AFMicr0/AnyScreenTouchScreen/README.md

# AnyScreenTouchScreen
ECE 445 Final Project

We have another repository for this project here:
https://github.com/Sakhiyuvio/Any-Screen-to-Touch-Screen
