AFMicr0/AnyScreenTouchScreen/Any-Screen-Touch-Screen_AnchorMod/Any-Screen-Touch-Screen_AnchorMod.kicad_pcb

## KiCad design Any-Screen-Touch-Screen_AnchorMod/Any-Screen-Touch-Screen_AnchorMod.kicad_pcb (2024-10-13)

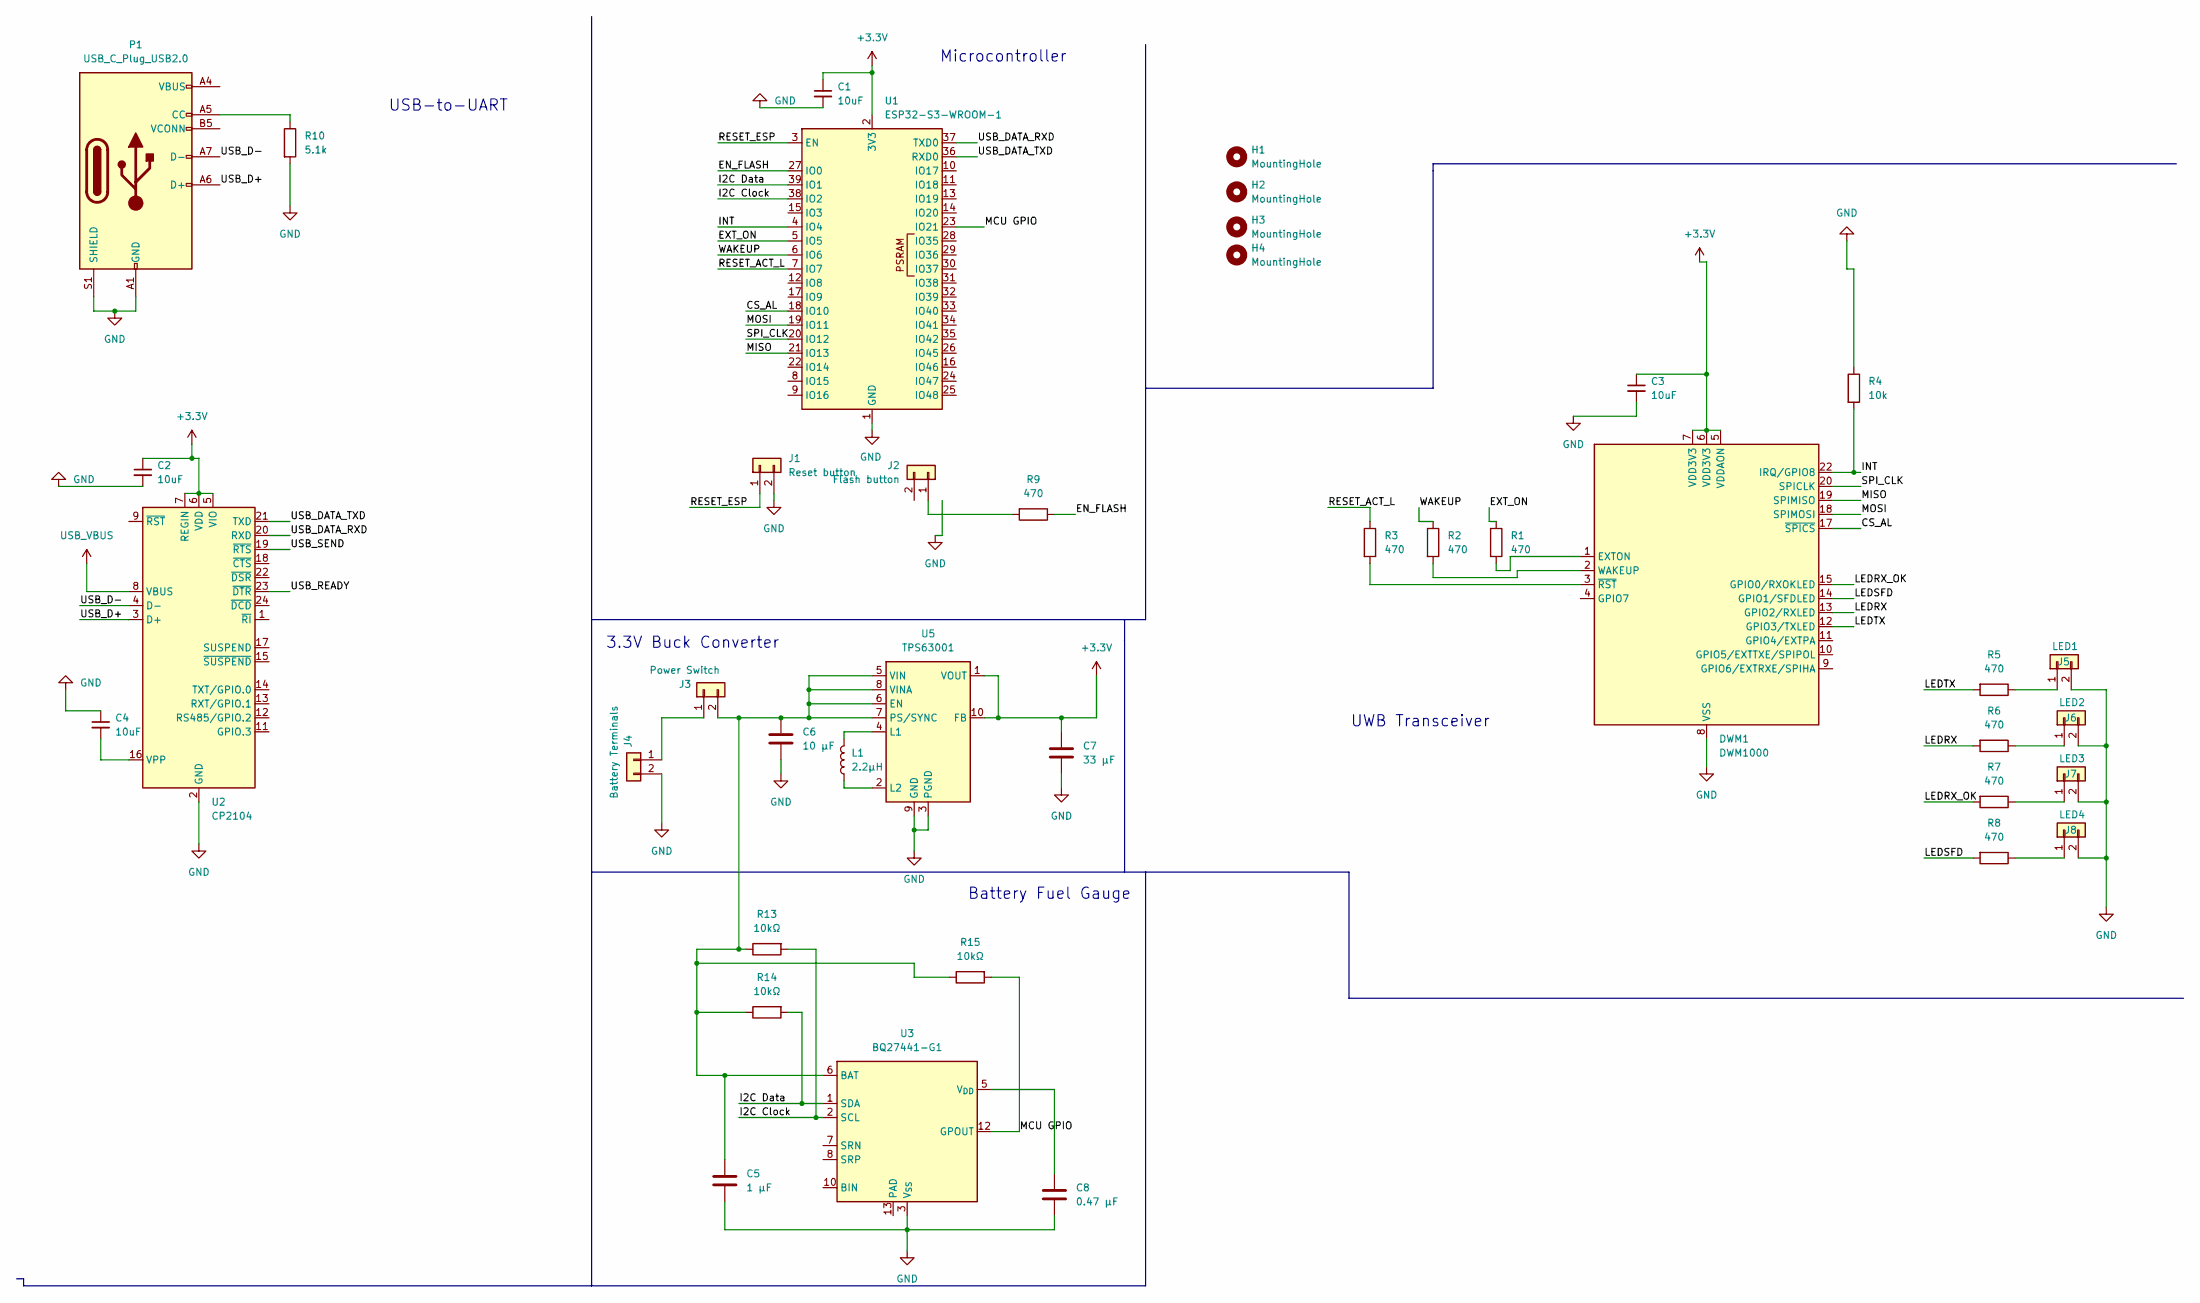
[picture p20: schematic Any-Screen-Touch-Screen_AnchorMod.kicad_sch]

Parts:
C1, C2, C3, C4: 10uF; C_0805_2012Metric_Pad1.18x1.45mm_HandSolder
C5: 1 μF; C_0805_2012Metric_Pad1.18x1.45mm_HandSolder
C6: 10 μF; C_0805_2012Metric_Pad1.18x1.45mm_HandSolder
C7: 33 μF; C_0805_2012Metric_Pad1.18x1.45mm_HandSolder
C8: 0.47 μF; C_0805_2012Metric_Pad1.18x1.45mm_HandSolder
DWM1: DWM1000
H1, H2, H3, H4: MountingHole; MountingHole_3.2mm_M3
J1: Reset button; Molex_KK-254_AE-6410-02A_1x02_P2.54mm_Vertical
J2: Flash button; Molex_KK-254_AE-6410-02A_1x02_P2.54mm_Vertical
J3: Power Switch; Molex_KK-254_AE-6410-02A_1x02_P2.54mm_Vertical
J4: Battery Terminals; Molex_KK-254_AE-6410-02A_1x02_P2.54mm_Vertical
J5: LED1; Molex_KK-254_AE-6410-02A_1x02_P2.54mm_Vertical
J6: LED2; Molex_KK-254_AE-6410-02A_1x02_P2.54mm_Vertical
J7: LED3; Molex_KK-254_AE-6410-02A_1x02_P2.54mm_Vertical
J8: LED4; Molex_KK-254_AE-6410-02A_1x02_P2.54mm_Vertical
L1: 2.2μH; IND_MSS5131_COC
P1: USB_C_Plug_USB2.0; USB_C_Plug_Molex_105444
R1, R2, R3, R5, R6, R7, R8, R9: 470; R_0805_2012Metric_Pad1.20x1.40mm_HandSolder
R4: 10k; R_0805_2012Metric_Pad1.20x1.40mm_HandSolder
R10: 5.1k; R_0805_2012Metric_Pad1.20x1.40mm_HandSolder
R13, R14, R15: 10kΩ; R_0805_2012Metric_Pad1.20x1.40mm_HandSolder
U1: ESP32-S3-WROOM-1
U2: CP2104; QFN-24-1EP_4x4mm_P0.5mm_EP2.7x2.7mm_ThermalVias
U3: BQ27441-G1; Texas_S-PDSO-N12
U5: TPS63001; Texas_DRC0010J_ThermalVias

Connections:
+3.3V: C1.1, C2.1, C3.1, C7.1, DWM1.5 (VDDAON), DWM1.6 (VDD3V3), DWM1.7 (VDD3V3), U1.2 (3V3), U2.5 (VIO), U2.6 (VDD), U2.7 (REGIN), U5.1 (VOUT), U5.10 (FB)
/CS_AL: DWM1.17 (~SPICS), U1.18 (IO10)
/EN_FLASH: R9.1, U1.27 (IO0)
/EXT_ON: R1.1, U1.5 (IO5)
/I2C Clock: R13.2, U1.38 (IO2), U3.2 (SCL)
/I2C Data: R14.2, U1.39 (IO1), U3.1 (SDA)
/INT: DWM1.22 (IRQ/GPIO8), R4.2, U1.4 (IO4)
/LEDRX: DWM1.13 (GPIO2/RXLED), R6.2
/LEDRX_OK: DWM1.15 (GPIO0/RXOKLED), R7.2
/LEDSFD: DWM1.14 (GPIO1/SFDLED), R8.2
/LEDTX: DWM1.12 (GPIO3/TXLED), R5.2
/MCU GPIO: R15.2, U1.23 (IO21), U3.12 (GPOUT)
/MISO: DWM1.19 (SPIMISO), U1.21 (IO13)
/MOSI: DWM1.18 (SPIMOSI), U1.19 (IO11)
/RESET_ACT_L: R3.1, U1.7 (IO7)
/RESET_ESP: J1.1, U1.3 (EN)
/SPI_CLK: DWM1.20 (SPICLK), U1.20 (IO12)
/USB_D+: P1.A6 (D+), U2.3 (D+)
/USB_D-: P1.A7 (D-), U2.4 (D-)
/USB_DATA_RXD: U1.37 (TXD0), U2.20 (RXD)
/USB_DATA_TXD: U1.36 (RXD0), U2.21 (TXD)
/USB_READY: U2.23 (~DTR)
/USB_SEND: U2.19 (~RTS)
/WAKEUP: R2.1, U1.6 (IO6)
GND: C1.2, C2.2, C3.2, C4.1, C5.2, C6.1, C7.2, C8.2, DWM1.8 (VSS), DWM1.16 (VSS), DWM1.21 (VSS), DWM1.23 (VSS), DWM1.24 (VSS), J1.2, J4.2, J5.2, J6.2, J7.2, J8.2, P1.A1 (GND), P1.A12 (GND), P1.B1 (GND), P1.B12 (GND), P1.S1 (SHIELD), R4.1, R10.2, U1.1 (GND), U1.40 (GND), U1.41 (GND), U2.2 (GND), U2.25 (GND), U3.3 (V_{SS}), U5.3 (PGND), U5.9 (GND), U5.11 (PGND)
unnamed: DWM1.1 (EXTON), R1.2
unnamed: DWM1.2 (WAKEUP), R2.2
unnamed: DWM1.3 (~RST), R3.2
unnamed: J2.1, R9.2
unnamed: J3.1, J4.1
unnamed: C5.1, C6.2, J3.2, R13.1, R14.1, R15.1, U3.6 (BAT), U5.5 (VIN), U5.6 (EN), U5.7 (PS/SYNC), U5.8 (VINA)
unnamed: J5.1, R5.1
unnamed: J6.1, R6.1
unnamed: J7.1, R7.1
unnamed: J8.1, R8.1
unnamed: P1.A5 (CC), R10.1
unnamed: P1.A4 (VBUS), P1.A9 (VBUS), P1.B4 (VBUS), P1.B9 (VBUS)
unnamed: C4.2, U2.16 (VPP)
unnamed: C8.1, U3.5 (V_{DD})
unnamed: L1.2, U5.4 (L1)
unnamed: L1.1, U5.2 (L2)
USB_VBUS: U2.8 (VBUS)

Notes on the sheet:
USB-to-UART
Microcontroller
3.3V Buck Converter
Battery Fuel Gauge
UWB Transceiver

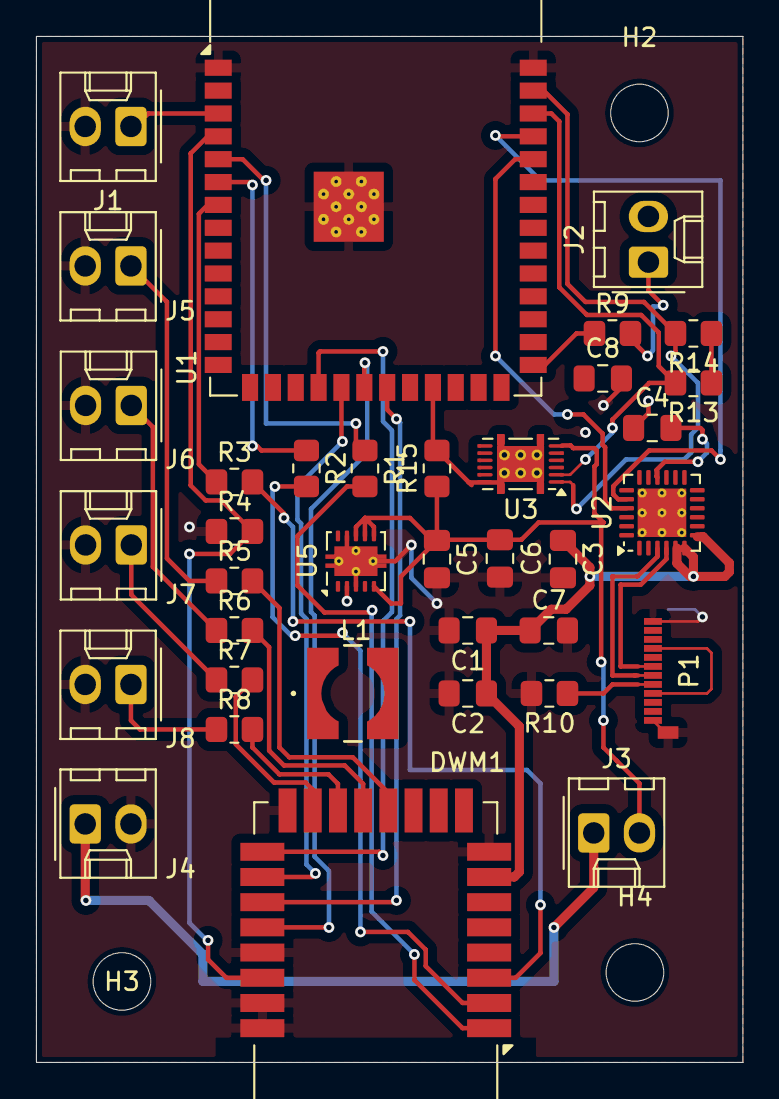
[picture p21: board Any-Screen-Touch-Screen_AnchorMod.kicad_pcb from above]

Board: 2 copper layers, 39.2 x 57.0 mm, 40 parts (0 on the bottom side), 39 nets.
