AFMicr0/AnyScreenTouchScreen/PCB design/Pen and Anchor Schematics/Any-Screen-Touch-Screen_AnchorMod.kicad_sch

## KiCad design PCB design/Pen and Anchor Schematics/Any-Screen-Touch-Screen_AnchorMod.kicad_sch (2024-10-01)

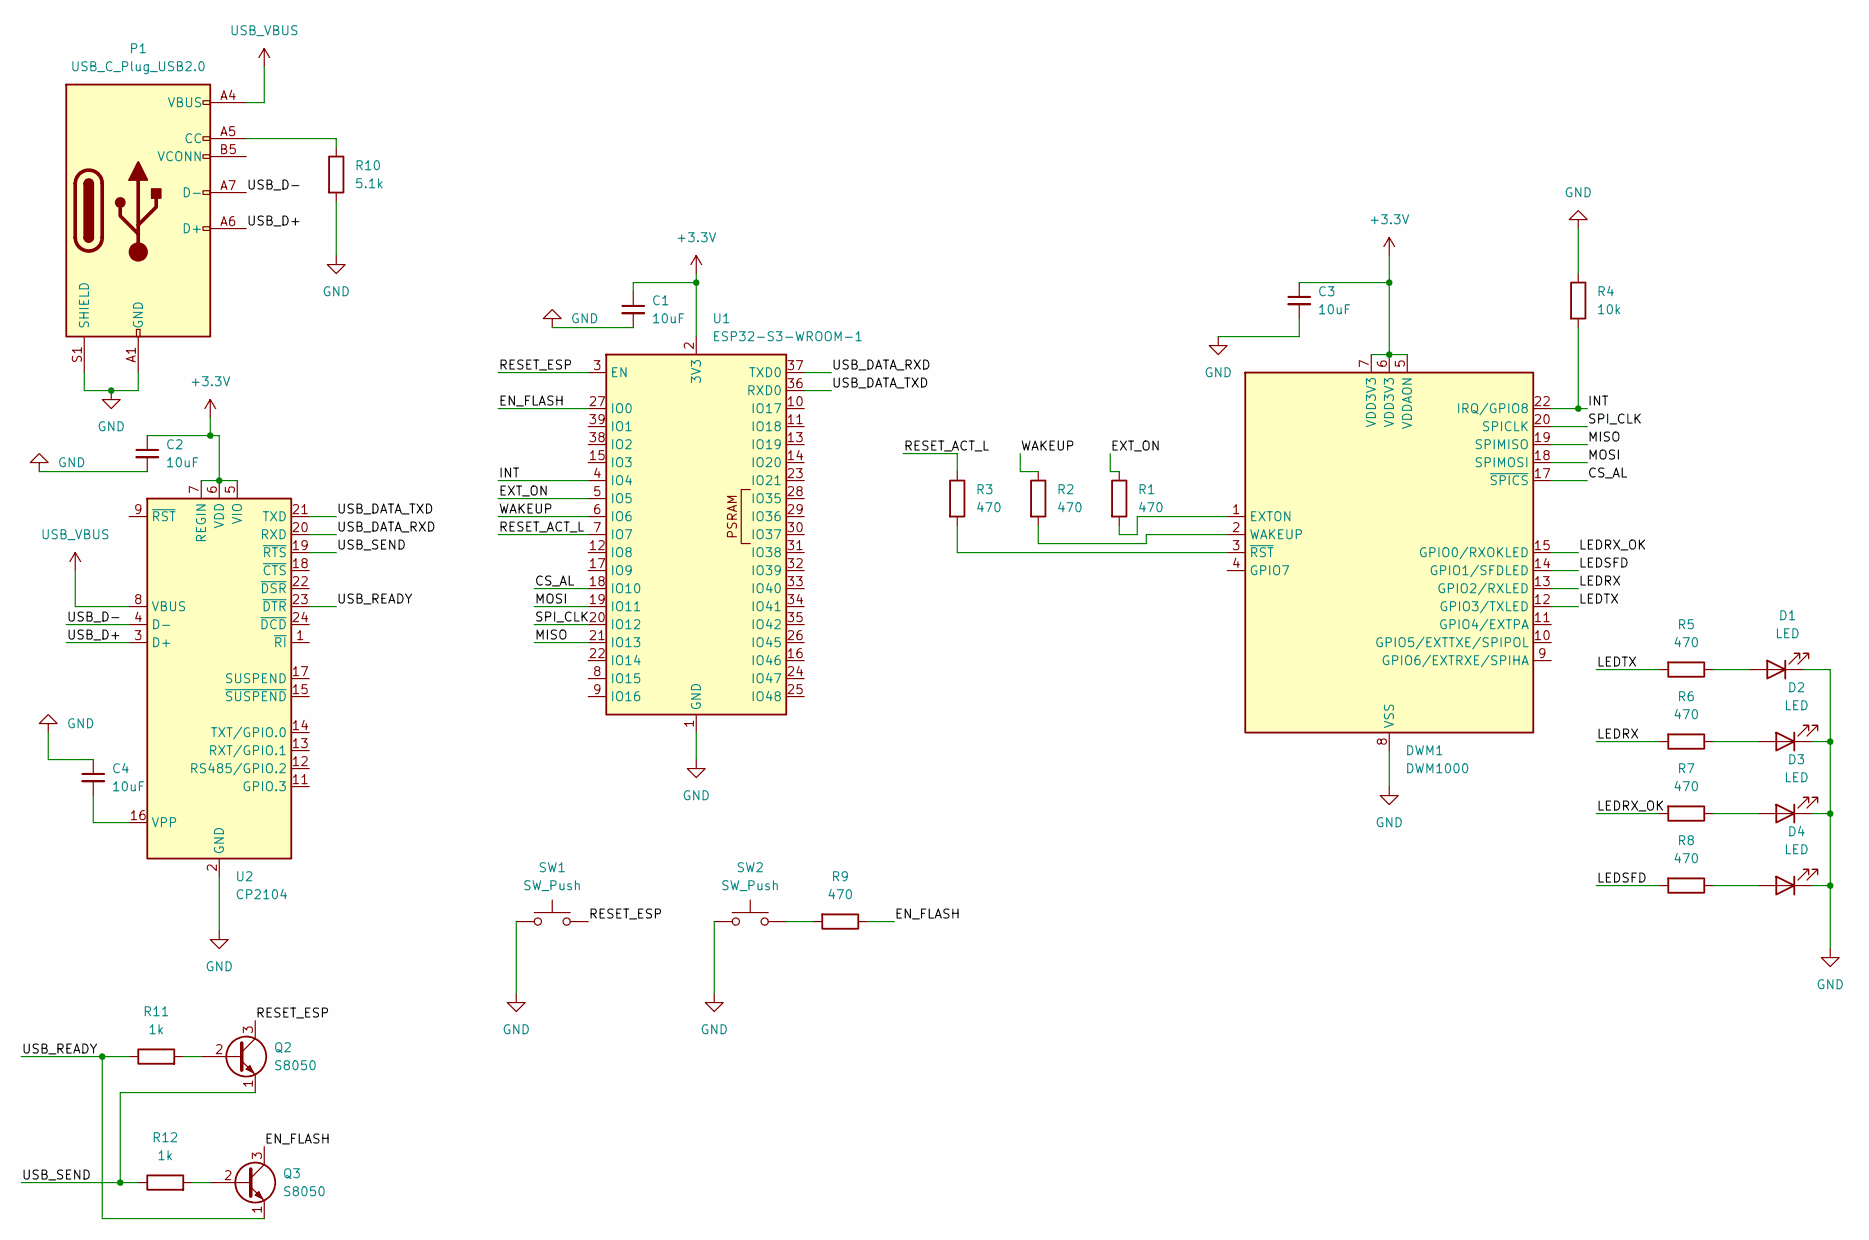
[picture p22: schematic Any-Screen-Touch-Screen_AnchorMod.kicad_sch]

Parts:
C1, C2, C3, C4: 10uF
D1, D2, D3, D4: LED
DWM1: DWM1000
P1: USB_C_Plug_USB2.0
Q2, Q3: S8050; TO-92_Inline
R1, R2, R3, R5, R6, R7, R8, R9: 470
R4: 10k
R10: 5.1k
R11, R12: 1k
SW1, SW2: SW_Push
U1: ESP32-S3-WROOM-1
U2: CP2104; QFN-24-1EP_4x4mm_P0.5mm_EP2.6x2.6mm

Connections:
+3.3V: C1.1, C2.1, C3.1, DWM1.5 (VDDAON), DWM1.6 (VDD3V3), DWM1.7 (VDD3V3), U1.2 (3V3), U2.5 (VIO), U2.6 (VDD), U2.7 (REGIN)
CS_AL: DWM1.17 (~SPICS), U1.18 (IO10)
EN_FLASH: Q3.3 (C), R9.1, U1.27 (IO0)
EXT_ON: R1.1, U1.5 (IO5)
GND: C1.2, C2.2, C3.2, C4.1, D1.1 (K), D2.1 (K), D3.1 (K), D4.1 (K), DWM1.8 (VSS), DWM1.16 (VSS), DWM1.21 (VSS), DWM1.23 (VSS), DWM1.24 (VSS), P1.A1 (GND), P1.A12 (GND), P1.B1 (GND), P1.B12 (GND), P1.S1 (SHIELD), R4.1, R10.2, SW1.1, SW2.1, U1.1 (GND), U1.40 (GND), U1.41 (GND), U2.2 (GND), U2.25 (GND)
INT: DWM1.22 (IRQ/GPIO8), R4.2, U1.4 (IO4)
LEDRX: DWM1.13 (GPIO2/RXLED), R6.2
LEDRX_OK: DWM1.15 (GPIO0/RXOKLED), R7.2
LEDSFD: DWM1.14 (GPIO1/SFDLED), R8.2
LEDTX: DWM1.12 (GPIO3/TXLED), R5.2
MISO: DWM1.19 (SPIMISO), U1.21 (IO13)
MOSI: DWM1.18 (SPIMOSI), U1.19 (IO11)
unnamed: C4.2, U2.16 (VPP)
unnamed: D1.2 (A), R5.1
unnamed: D2.2 (A), R6.1
unnamed: D3.2 (A), R7.1
unnamed: D4.2 (A), R8.1
unnamed: DWM1.1 (EXTON), R1.2
unnamed: DWM1.2 (WAKEUP), R2.2
unnamed: DWM1.3 (~RST), R3.2
unnamed: P1.A5 (CC), R10.1
unnamed: Q2.2 (B), R11.2
unnamed: Q3.2 (B), R12.2
unnamed: R9.2, SW2.2
RESET_ACT_L: R3.1, U1.7 (IO7)
RESET_ESP: Q2.3 (C), SW1.2, U1.3 (EN)
SPI_CLK: DWM1.20 (SPICLK), U1.20 (IO12)
USB_D+: P1.A6 (D+), U2.3 (D+)
USB_D-: P1.A7 (D-), U2.4 (D-)
USB_DATA_RXD: U1.37 (TXD0), U2.20 (RXD)
USB_DATA_TXD: U1.36 (RXD0), U2.21 (TXD)
USB_READY: Q3.1 (E), R11.1, U2.23 (~DTR)
USB_SEND: Q2.1 (E), R12.1, U2.19 (~RTS)
USB_VBUS: P1.A4 (VBUS), P1.A9 (VBUS), P1.B4 (VBUS), P1.B9 (VBUS), U2.8 (VBUS)
WAKEUP: R2.1, U1.6 (IO6)
