AFMicr0/AnyScreenTouchScreen/PCB design/Pen and Anchor Schematics/Any-Screen-Touch-Screen_Pen.kicad_sch

## KiCad design PCB design/Pen and Anchor Schematics/Any-Screen-Touch-Screen_Pen.kicad_sch (2024-10-01)

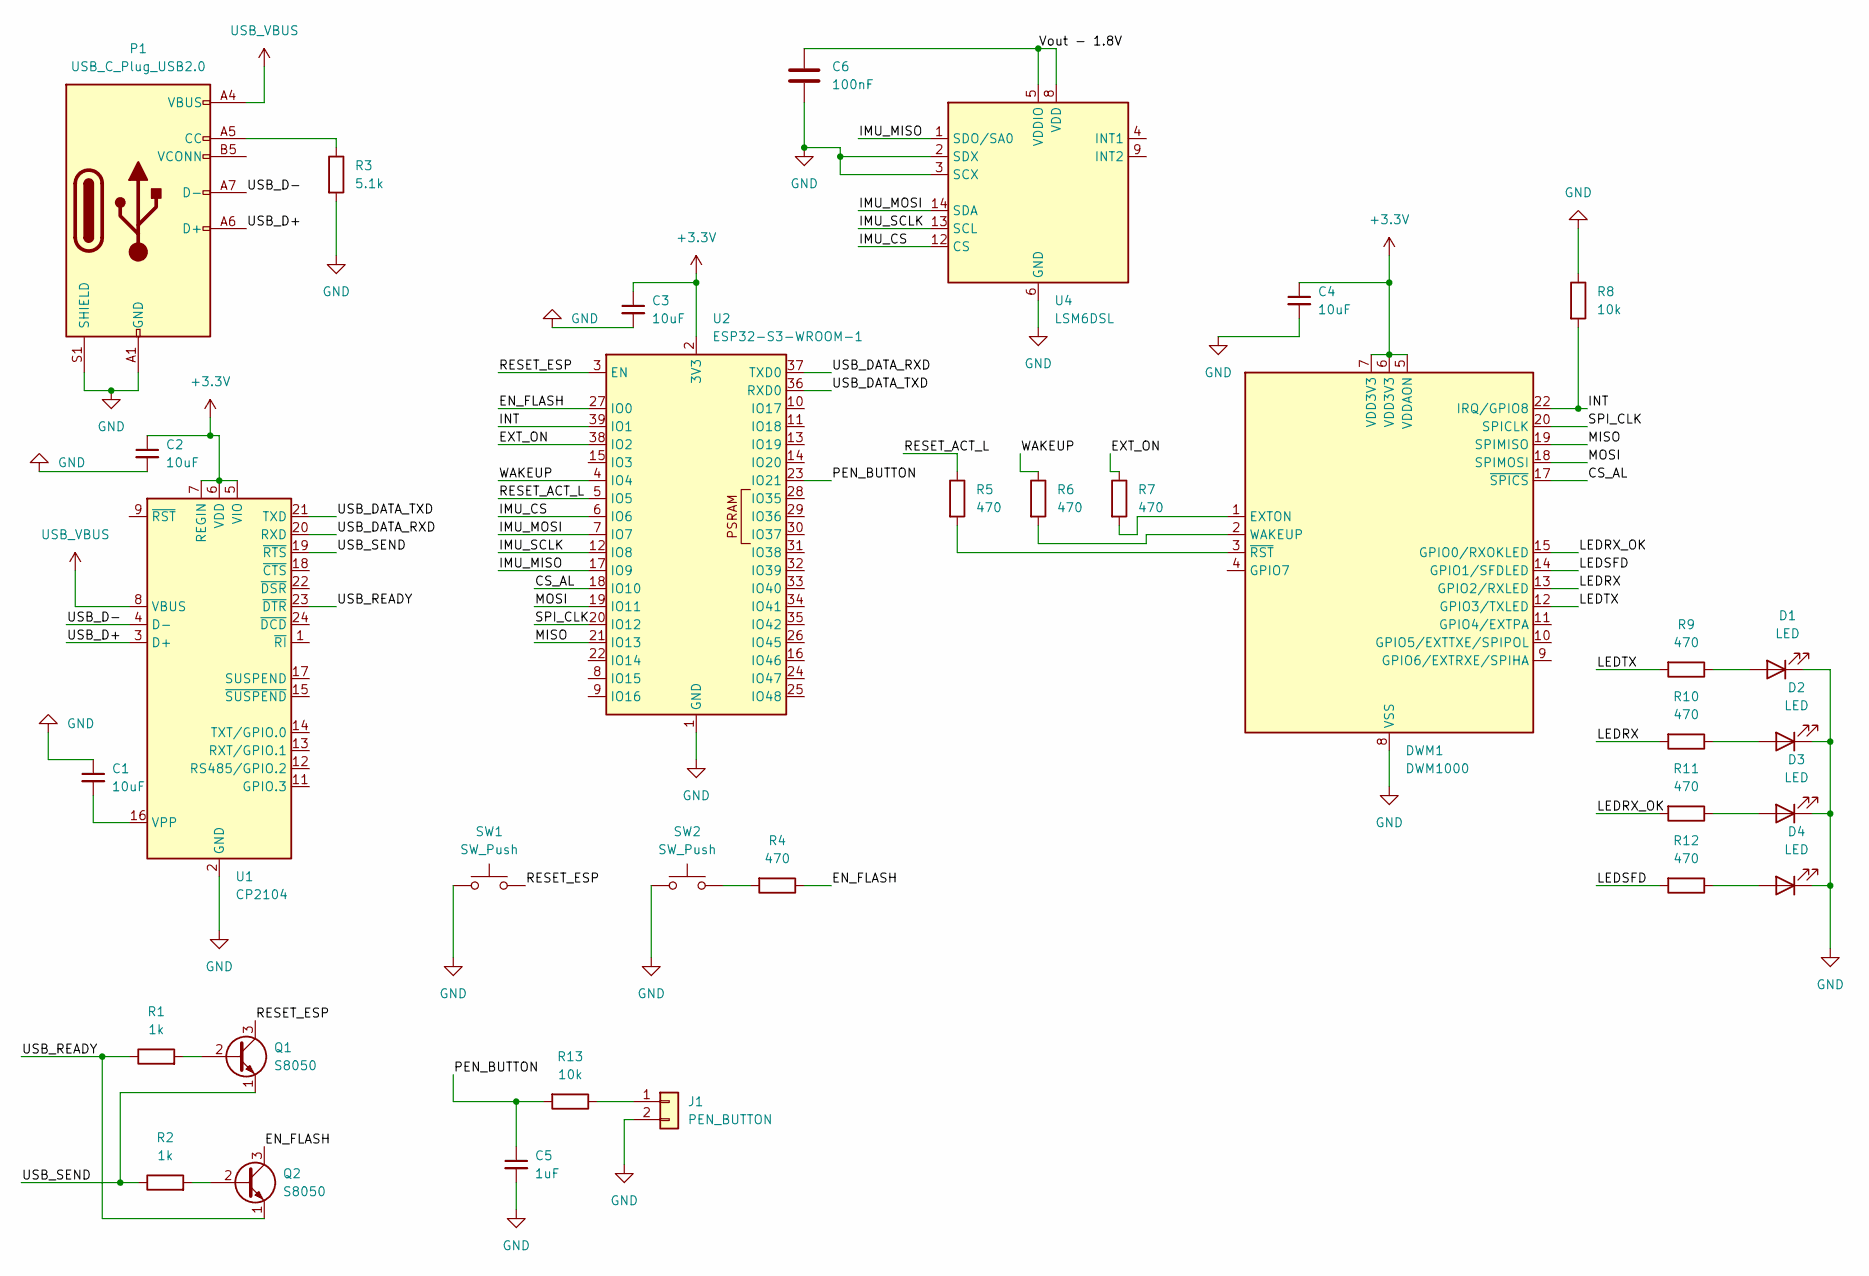
[picture p23: schematic Any-Screen-Touch-Screen_Pen.kicad_sch]

Parts:
C1, C2, C3, C4: 10uF
C5: 1uF
C6: 100nF
D1, D2, D3, D4: LED
DWM1: DWM1000
J1: PEN_BUTTON
P1: USB_C_Plug_USB2.0
Q1, Q2: S8050; TO-92_Inline
R1, R2: 1k
R3: 5.1k
R4, R5, R6, R7, R9, R10, R11, R12: 470
R8, R13: 10k
SW1, SW2: SW_Push
U1: CP2104; QFN-24-1EP_4x4mm_P0.5mm_EP2.6x2.6mm
U2: ESP32-S3-WROOM-1
U4: LSM6DSL; LGA-14_3x2.5mm_P0.5mm_LayoutBorder3x4y

Connections:
+3.3V: C2.1, C3.1, C4.1, DWM1.5 (VDDAON), DWM1.6 (VDD3V3), DWM1.7 (VDD3V3), U1.5 (VIO), U1.6 (VDD), U1.7 (REGIN), U2.2 (3V3)
CS_AL: DWM1.17 (~SPICS), U2.18 (IO10)
EN_FLASH: Q2.3 (C), R4.1, U2.27 (IO0)
EXT_ON: R7.1, U2.38 (IO2)
GND: C1.1, C2.2, C3.2, C4.2, C5.2, C6.2, D1.1 (K), D2.1 (K), D3.1 (K), D4.1 (K), DWM1.8 (VSS), DWM1.16 (VSS), DWM1.21 (VSS), DWM1.23 (VSS), DWM1.24 (VSS), J1.2, P1.A1 (GND), P1.A12 (GND), P1.B1 (GND), P1.B12 (GND), P1.S1 (SHIELD), R3.2, R8.1, SW1.1, SW2.1, U1.2 (GND), U1.25 (GND), U2.1 (GND), U2.40 (GND), U2.41 (GND), U4.2 (SDX), U4.3 (SCX), U4.6 (GND), U4.7 (GND)
IMU_CS: U2.6 (IO6), U4.12 (CS)
IMU_MISO: U2.17 (IO9), U4.1 (SDO/SA0)
IMU_MOSI: U2.7 (IO7), U4.14 (SDA)
IMU_SCLK: U2.12 (IO8), U4.13 (SCL)
INT: DWM1.22 (IRQ/GPIO8), R8.2, U2.39 (IO1)
LEDRX: DWM1.13 (GPIO2/RXLED), R10.2
LEDRX_OK: DWM1.15 (GPIO0/RXOKLED), R11.2
LEDSFD: DWM1.14 (GPIO1/SFDLED), R12.2
LEDTX: DWM1.12 (GPIO3/TXLED), R9.2
MISO: DWM1.19 (SPIMISO), U2.21 (IO13)
MOSI: DWM1.18 (SPIMOSI), U2.19 (IO11)
unnamed: C1.2, U1.16 (VPP)
unnamed: D1.2 (A), R9.1
unnamed: D2.2 (A), R10.1
unnamed: D3.2 (A), R11.1
unnamed: D4.2 (A), R12.1
unnamed: DWM1.1 (EXTON), R7.2
unnamed: DWM1.2 (WAKEUP), R6.2
unnamed: DWM1.3 (~RST), R5.2
unnamed: J1.1, R13.1
unnamed: P1.A5 (CC), R3.1
unnamed: Q1.2 (B), R1.2
unnamed: Q2.2 (B), R2.2
unnamed: R4.2, SW2.2
PEN_BUTTON: C5.1, R13.2, U2.23 (IO21)
RESET_ACT_L: R5.1, U2.5 (IO5)
RESET_ESP: Q1.3 (C), SW1.2, U2.3 (EN)
SPI_CLK: DWM1.20 (SPICLK), U2.20 (IO12)
USB_D+: P1.A6 (D+), U1.3 (D+)
USB_D-: P1.A7 (D-), U1.4 (D-)
USB_DATA_RXD: U1.20 (RXD), U2.37 (TXD0)
USB_DATA_TXD: U1.21 (TXD), U2.36 (RXD0)
USB_READY: Q2.1 (E), R1.1, U1.23 (~DTR)
USB_SEND: Q1.1 (E), R2.1, U1.19 (~RTS)
USB_VBUS: P1.A4 (VBUS), P1.A9 (VBUS), P1.B4 (VBUS), P1.B9 (VBUS), U1.8 (VBUS)
Vout - 1.8V: C6.1, U4.5 (VDDIO), U4.8 (VDD)
WAKEUP: R6.1, U2.4 (IO4)
