AFMicr0/AnyScreenTouchScreen/PCB design/power subsystem/power subsystem.kicad_sch

## KiCad design PCB design/power subsystem/power subsystem.kicad_sch (2024-10-01)

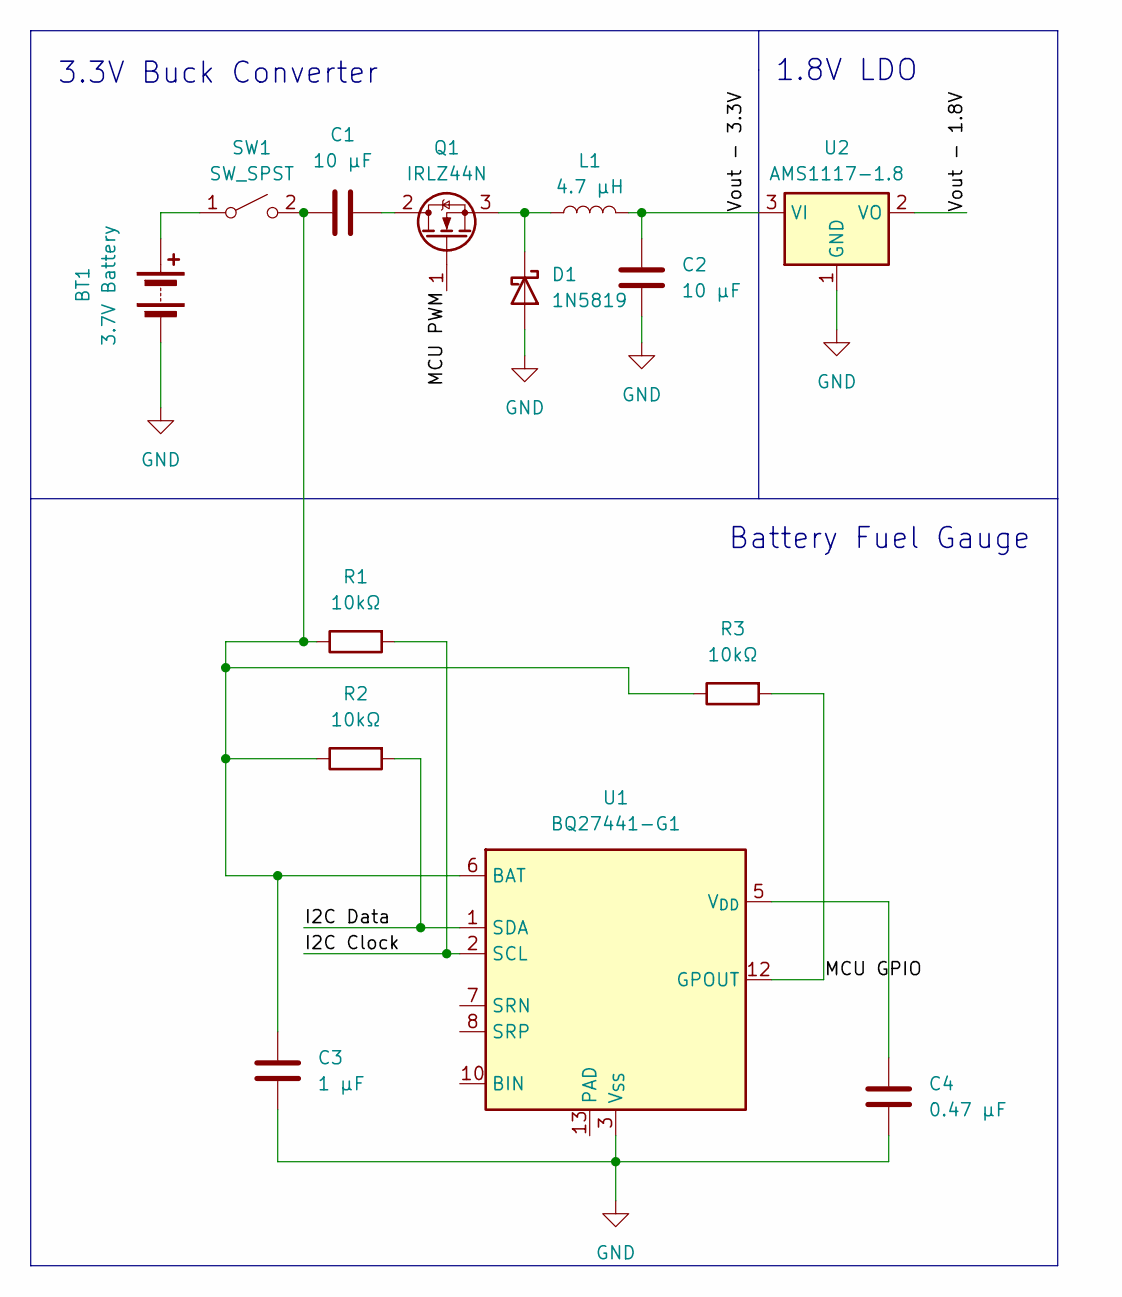
[picture p24: schematic power subsystem.kicad_sch]

Parts:
BT1: 3.7V Battery
C1, C2: 10 μF
C3: 1 μF
C4: 0.47 μF
D1: 1N5819; D_DO-41_SOD81_P10.16mm_Horizontal
L1: 4.7 μH
Q1: IRLZ44N; TO-220-3_Vertical
R1, R2, R3: 10kΩ
SW1: SW_SPST
U1: BQ27441-G1; Texas_S-PDSO-N12
U2: AMS1117-1.8; SOT-223-3_TabPin2

Connections:
GND: BT1.2 (-), C2.2, C3.2, C4.2, D1.2 (A), U1.3 (V_{SS}), U2.1 (GND)
I2C Clock: R1.2, U1.2 (SCL)
I2C Data: R2.2, U1.1 (SDA)
MCU GPIO: R3.2, U1.12 (GPOUT)
MCU PWM: Q1.1 (G)
unnamed: BT1.1 (+), SW1.1 (A)
unnamed: C1.1, Q1.2 (D)
unnamed: C1.2, C3.1, R1.1, R2.1, R3.1, SW1.2 (B), U1.6 (BAT)
unnamed: C4.1, U1.5 (V_{DD})
unnamed: D1.1 (K), L1.1, Q1.3 (S)
Vout - 1.8V: U2.2 (VO)
Vout - 3.3V: C2.1, L1.2, U2.3 (VI)

Notes on the sheet:
3.3V Buck Converter
1.8V LDO
Battery Fuel Gauge
