AFMicr0/AnyScreenTouchScreen/(commit log)

2024-09-25 updated lab notebook and power subsystem schematics
    [power subsystem.kicad_pcb, power subsystem.kicad_sch]
2024-10-01 updated Notebook and pcb design files
    [Any-Screen-Touch-Screen_AnchorMod.kicad_sch, Any-Screen-Touch-Screen_Pen.kicad_sch, power subsystem.kicad_sch]
2024-10-01 Anchor Subsystem Schematic Design
    [Any-Screen-Touch-Screen_AnchorMod.kicad_pcb, Any-Screen-Touch-Screen_AnchorMod.kicad_sch]
2024-10-01 Pen Subsystem Schematic Design
    [Any-Screen-Touch-Screen_Pen.kicad_pcb, Any-Screen-Touch-Screen_Pen.kicad_sch]
2024-10-10 Merged power subsystem into pen and anchor schematics, changed input/output devices to pin connectors; also updated lab notebook
    [Any-Screen-Touch-Screen_AnchorMod.kicad_sch, Any-Screen-Touch-Screen_Pen.kicad_sch]
2024-10-11 Started PCB layout and organized components
    [Any-Screen-Touch-Screen_AnchorMod.kicad_pcb, Any-Screen-Touch-Screen_AnchorMod.kicad_sch, Any-Screen-Touch-Screen_Pen.kicad_sch]
2024-10-11 did most of the PCB routing, updated lab notebook
    [Any-Screen-Touch-Screen_AnchorMod.kicad_pcb]
2024-10-13 update pcb
    [Any-Screen-Touch-Screen_AnchorMod.kicad_pcb]
